virtualgrub39/RREAPER/hardware/rreaper.kicad_pcb

## KiCad design hardware/rreaper.kicad_pcb (2026-04-25)

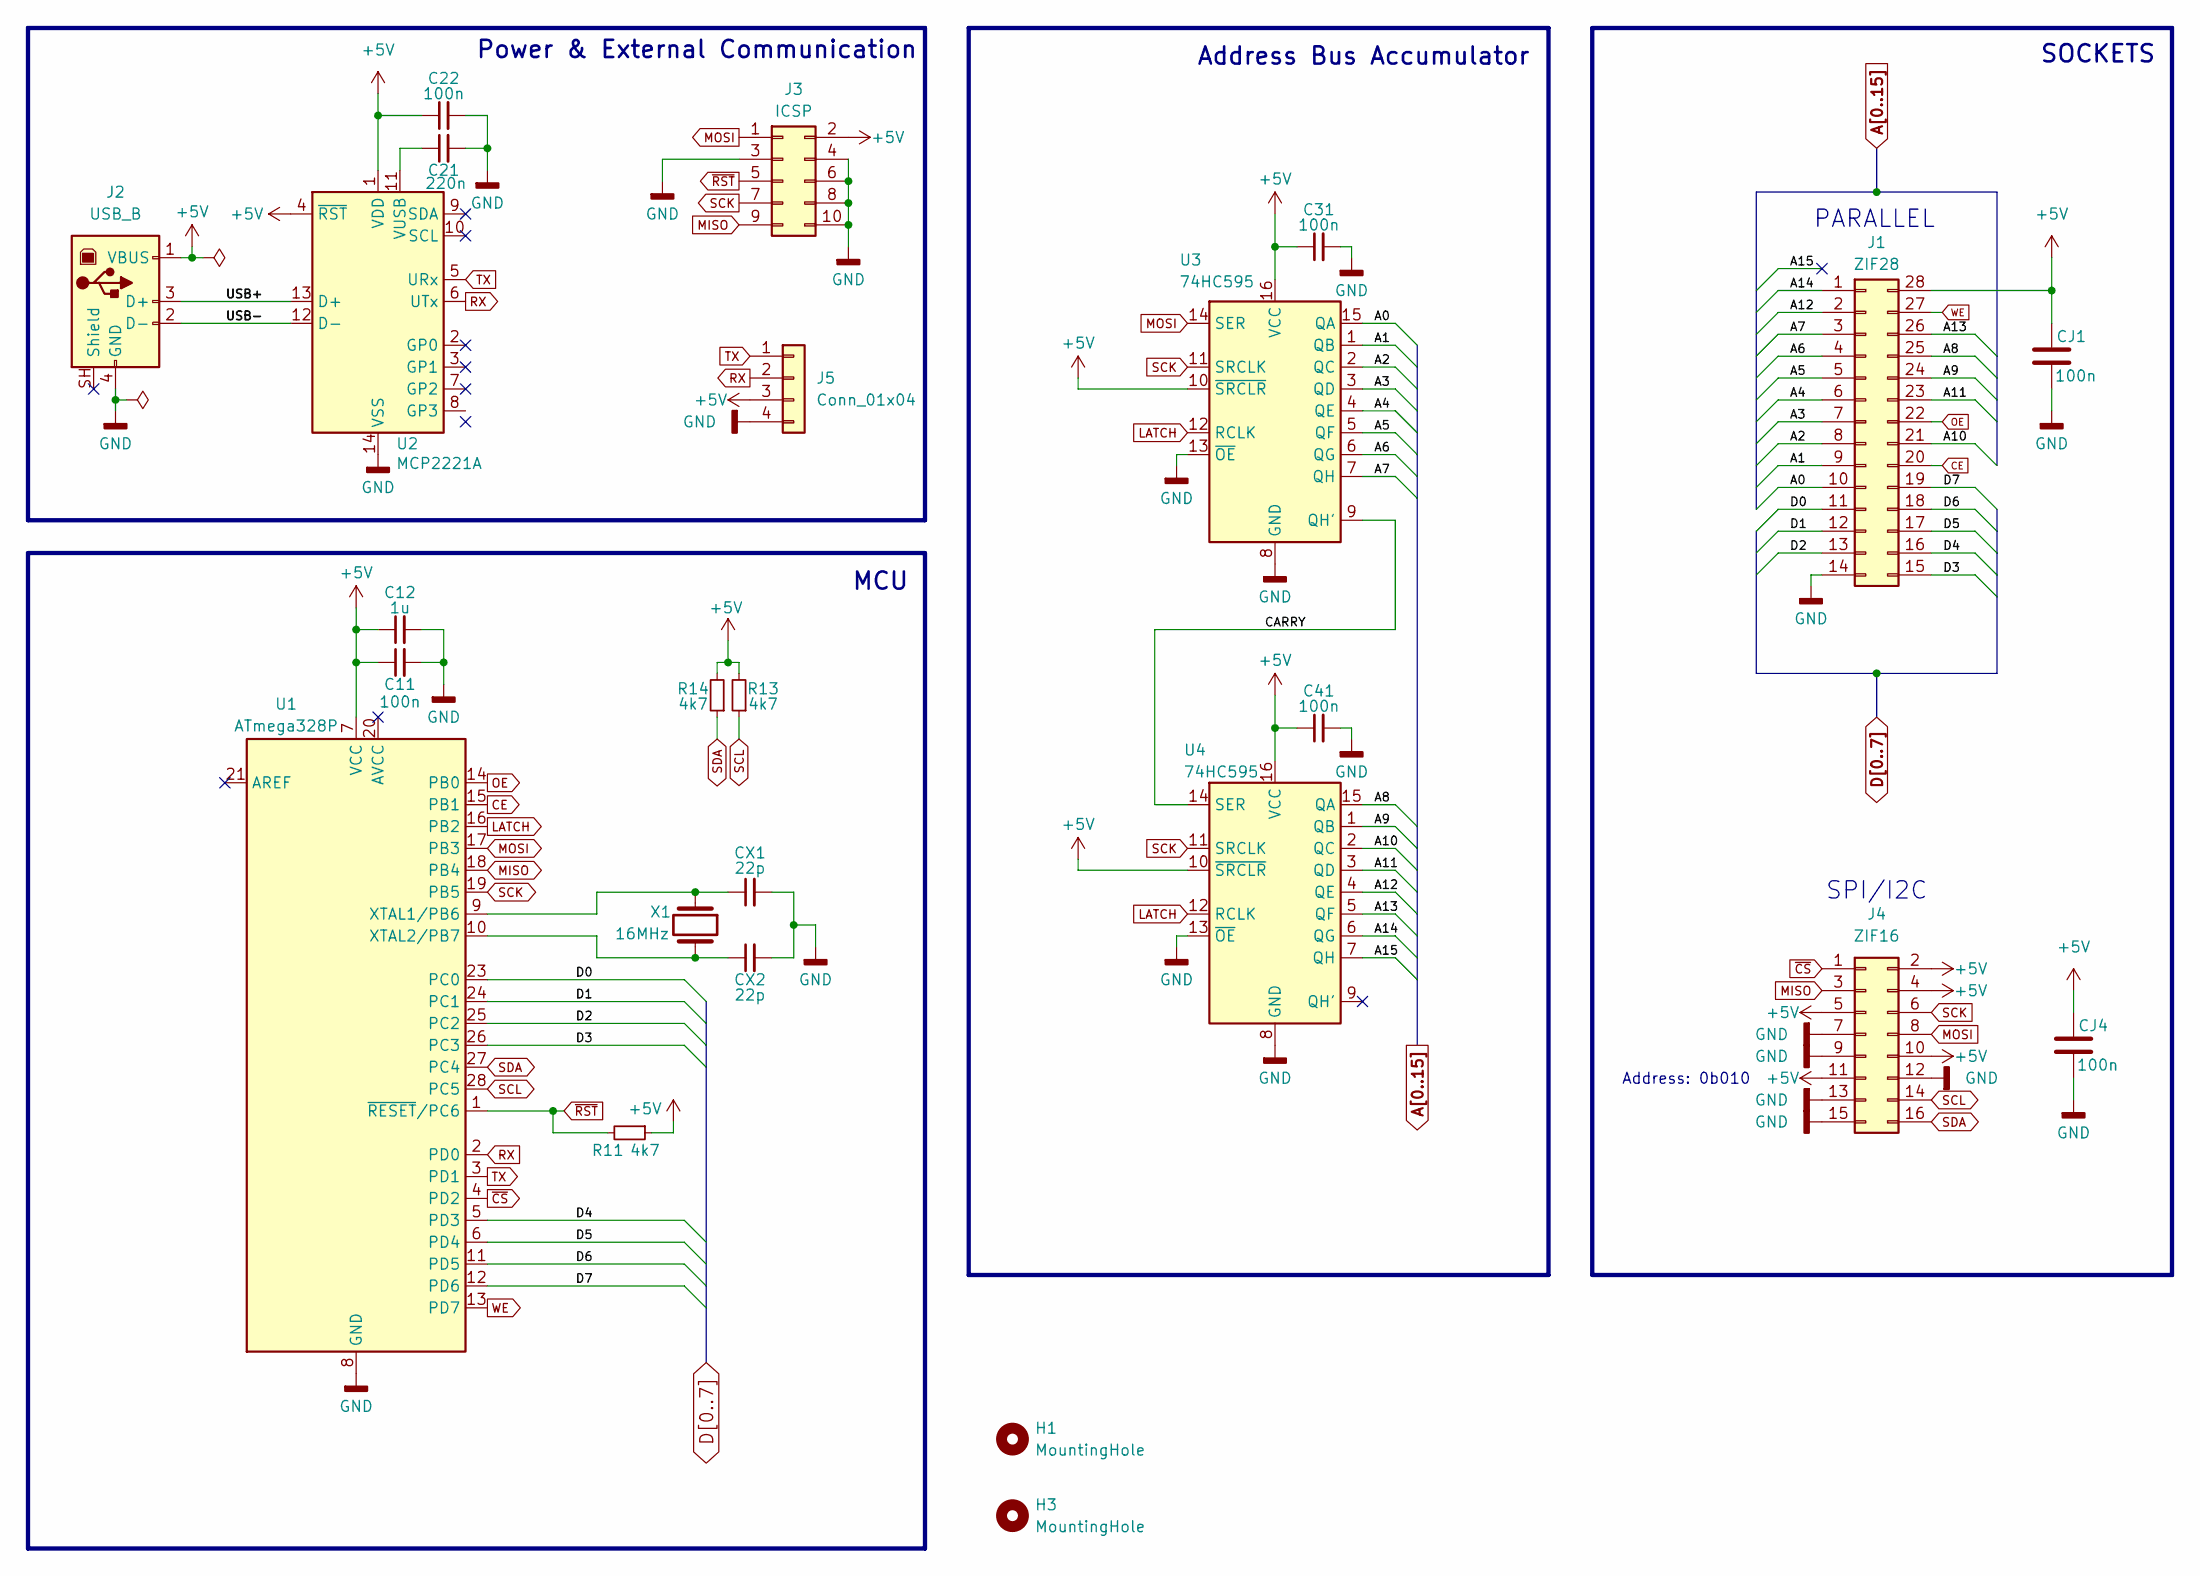
[picture p1: schematic rreaper.kicad_sch, Atmega328P 28C64/28C256 USB EEPROM programmer]

Parts:
C11, C22, C31, C41: 100n; C_Disc_D5.0mm_W2.5mm_P2.50mm
C12: 1u; C_Disc_D5.0mm_W2.5mm_P2.50mm
C21: 220n; C_Disc_D5.0mm_W2.5mm_P2.50mm
CJ1, CJ4: 100n; C_Disc_D5.0mm_W2.5mm_P2.50mm
CX1, CX2: 22p; C_Disc_D5.0mm_W2.5mm_P2.50mm
H1, H3: MountingHole; MountingHole_3.2mm_M3
J1: ZIF28; DIP_Socket-28_W11.9mm_W12.7mm_W15.24mm_W17.78mm_W18.5mm_3M_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
J2: USB_B; USB_B_Lumberg_2411_02_Horizontal
J3: ICSP; IDC-Header_2x05_P2.54mm_Vertical
J4: ZIF16; DIP_Socket-16_W4.3mm_W5.08mm_W7.62mm_W10.16mm_W10.9mm_3M_21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
J5: Conn_01x04; PinHeader_1x04_P2.54mm_Vertical
R11, R13, R14: 4k7; R_Axial_DIN0207_L6.3mm_D2.5mm_P7.62mm_Horizontal
U1: ATmega328P; DIP-28_W7.62mm_Socket
U2: MCP2221A; DIP-14_W7.62mm_Socket
U3, U4: 74HC595; DIP-16_W7.62mm_Socket
X1: 16MHz; Crystal_HC18-U_Vertical

Connections:
+5V: C11.1, C12.1, C22.1, C31.1, C41.1, CJ1.2, CJ4.2, J1.28, J2.1 (VBUS), J3.2, J4.2, J4.4, J4.5, J4.10, J4.11, J5.3, R11.1, R13.2, R14.2, U1.7 (VCC), U2.1 (VDD), U2.4 (~RST), U3.10 (~SRCLR), U3.16 (VCC), U4.10 (~SRCLR), U4.16 (VCC)
/CARRY: U3.9 (QH'), U4.14 (SER)
/USB+: J2.3 (D+), U2.13 (D+)
/USB-: J2.2 (D-), U2.12 (D-)
A0: J1.10, U3.15 (QA)
A1: J1.9, U3.1 (QB)
A2: J1.8, U3.2 (QC)
A3: J1.7, U3.3 (QD)
A4: J1.6, U3.4 (QE)
A5: J1.5, U3.5 (QF)
A6: J1.4, U3.6 (QG)
A7: J1.3, U3.7 (QH)
A8: J1.25, U4.15 (QA)
A9: J1.24, U4.1 (QB)
A10: J1.21, U4.2 (QC)
A11: J1.23, U4.3 (QD)
A12: J1.2, U4.4 (QE)
A13: J1.26, U4.5 (QF)
A14: J1.1, U4.6 (QG)
A15: U4.7 (QH)
CE: J1.20, U1.15 (PB1)
D0: J1.11, U1.23 (PC0)
D1: J1.12, U1.24 (PC1)
D2: J1.13, U1.25 (PC2)
D3: J1.15, U1.26 (PC3)
D4: J1.16, U1.5 (PD3)
D5: J1.17, U1.6 (PD4)
D6: J1.18, U1.11 (PD5)
D7: J1.19, U1.12 (PD6)
GND: C11.2, C12.2, C21.2, C22.2, C31.2, C41.2, CJ1.1, CJ4.1, CX1.2, CX2.2, J1.14, J2.4 (GND), J3.3, J3.4, J3.6, J3.8, J3.10, J4.7, J4.9, J4.12, J4.13, J4.15, J5.4, U1.8 (GND), U1.22 (GND), U2.14 (VSS), U3.8 (GND), U3.13 (~OE), U4.8 (GND), U4.13 (~OE)
LATCH: U1.16 (PB2), U3.12 (RCLK), U4.12 (RCLK)
MISO: J3.9, J4.3, U1.18 (PB4)
MOSI: J3.1, J4.8, U1.17 (PB3), U3.14 (SER)
unnamed: CX1.1, U1.9 (XTAL1/PB6), X1.1
unnamed: CX2.1, U1.10 (XTAL2/PB7), X1.2
unnamed: C21.1, U2.11 (VUSB)
OE: J1.22, U1.14 (PB0)
RX: J5.2, U1.2 (PD0), U2.6 (UTx)
SCK: J3.7, J4.6, U1.19 (PB5), U3.11 (SRCLK), U4.11 (SRCLK)
SCL: J4.14, R13.1, U1.28 (PC5)
SDA: J4.16, R14.1, U1.27 (PC4)
TX: J5.1, U1.3 (PD1), U2.5 (URx)
WE: J1.27, U1.13 (PD7)
~CS: J4.1, U1.4 (PD2)
~RST: J3.5, R11.2, U1.1 (~RESET/PC6)

Notes on the sheet:
Power & External Communication
PARALLEL
SPI/I2C
Address Bus Accumulator
SOCKETS
Address: 0b010
MCU

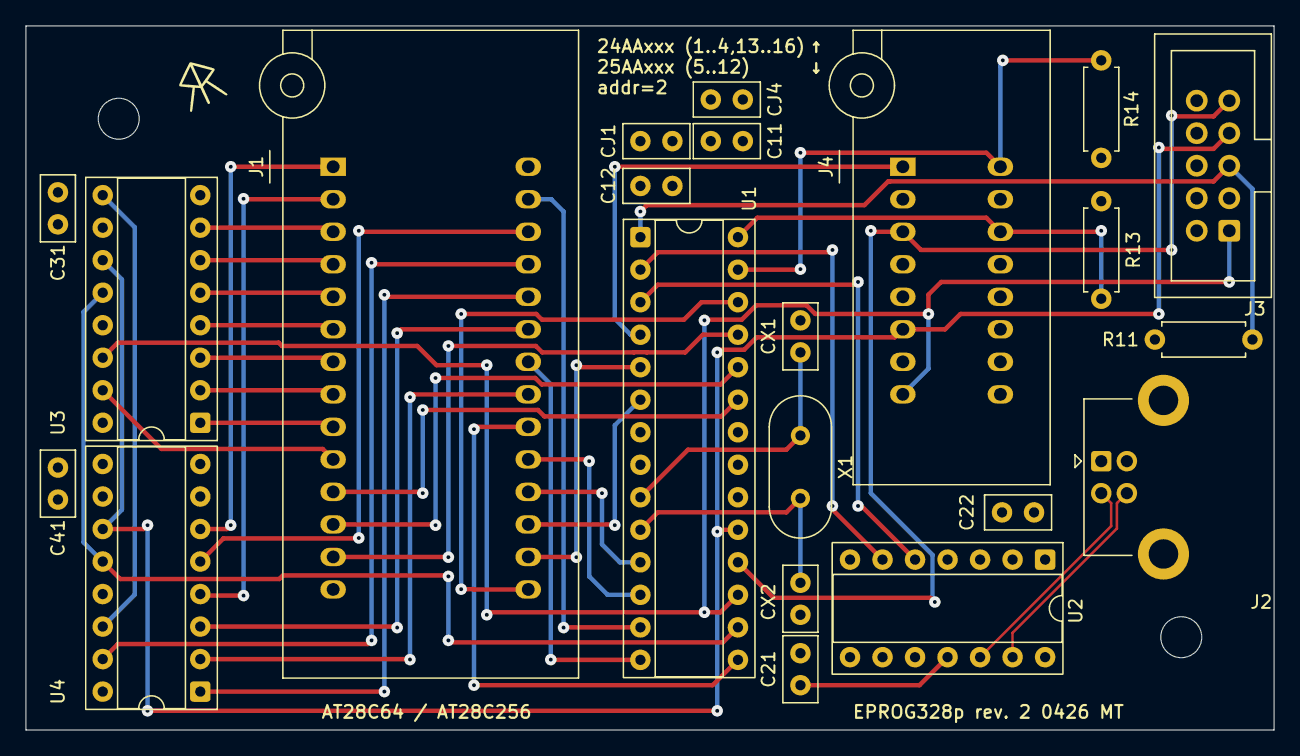
[picture p2: board rreaper.kicad_pcb from above]

Board: 4 copper layers, 97.5 x 55.0 mm, 24 parts (0 on the bottom side), 44 nets.
