virtualgrub39/RREAPER/(commit log)

2026-03-29 replaced flat file structure with source and include directories
    [checksum.c, checksum.h, eeprom.c, eeprom.h, ihex.c, ihex.h, main.c, parallel-port.c]
2026-03-29 added verify command; added simple python driver
2026-03-30 removed bum-ass LLM python driver
2026-03-30 added base for C++/Qt UI PC driver
2026-04-03 driver: added basic state-machine
2026-04-03 added hardware directory and project files
    [rreaper.kicad_pcb, rreaper.kicad_sch]
2026-04-03 added license header to driver files
2026-04-03 added basic hardware schematic
    [rreaper.kicad_sch]
2026-04-06 added basic PCB layout
    [rreaper.kicad_pcb, rreaper.kicad_sch]
2026-04-10 completed first PCB layout
    [rreaper.kicad_pcb, rreaper.kicad_sch]
2026-04-14 hardware: replaced USB with RS485 and external power; redesigned PCB
    [rreaper.kicad_pcb, rreaper.kicad_sch]
2026-04-16 migrated to kicad 10; added symbol for avr16dd28
    [rreaper.kicad_pcb, rreaper.kicad_sch]
2026-04-25 went back to USB; added serial eeprom socket; completed new layout
    [rreaper.kicad_pcb, rreaper.kicad_sch]
2026-04-25 basically a firmware rewrite: added CRC module and command; rewritten EEPROM module to work with multiple different device types; added device switching command; introduced more standard error / erro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
    [config.def.h, crc.c, crc.h, eeprom.c, eeprom.h, error.h, ihex.c, ihex.h]
2026-04-25 added datasheets for chips used in the project; removed unused UART header from schematic
    [rreaper.kicad_sch]
