virtualgrub39/RREAPER/(notices)

Notices in the files:
firmware/source/eeprom.c:
under the terms of the GNU General Public License, version 3, or any later version.
